LHC324/Valve-hall-charger/Document/Cubemx更新代码时手动变更部分.jpg

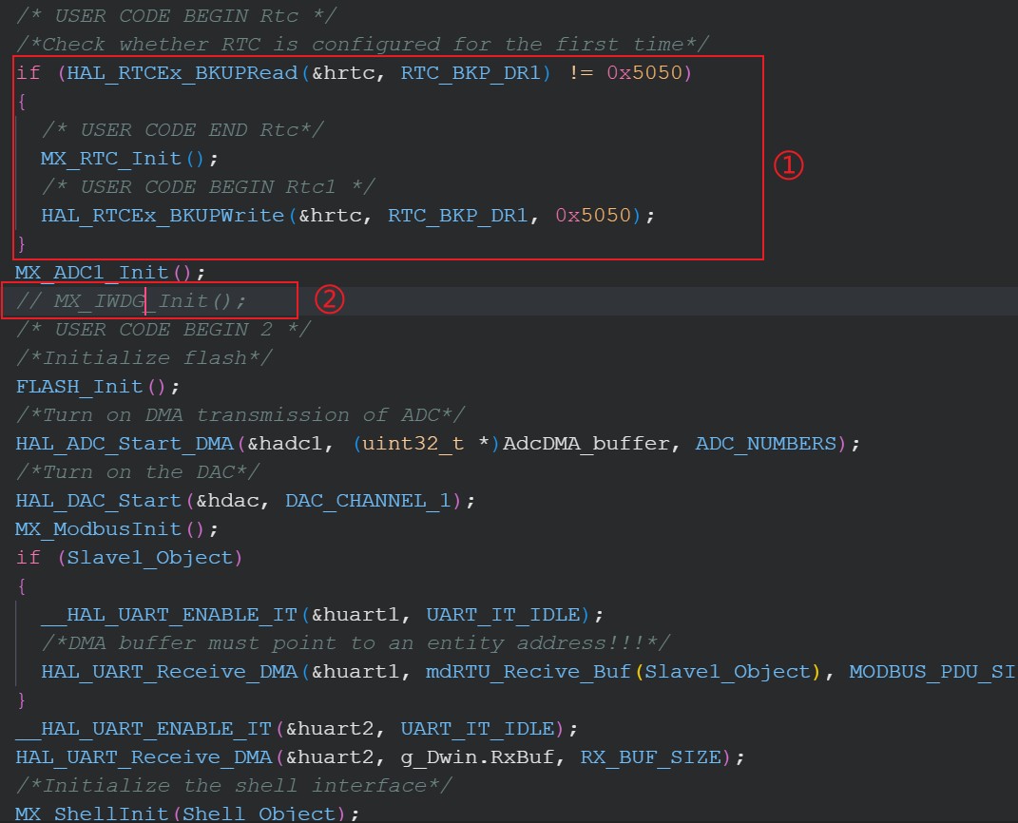
Document/Cubemx更新代码时手动变更部分.jpg
