LHC324/Valve-hall-charger/Dwin Project/DWIN_SET/02_充电设置.jpg

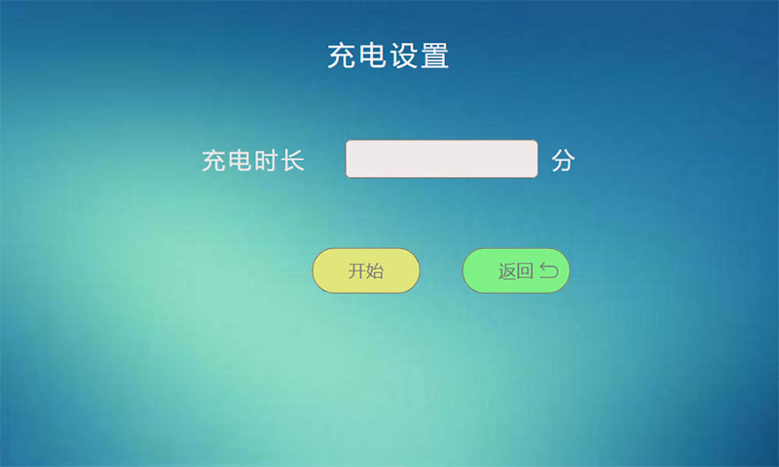
Dwin Project/DWIN_SET/02_充电设置.jpg
