LHC324/Valve-hall-charger/Dwin Project/DWIN_SET/03_放电设置.jpg

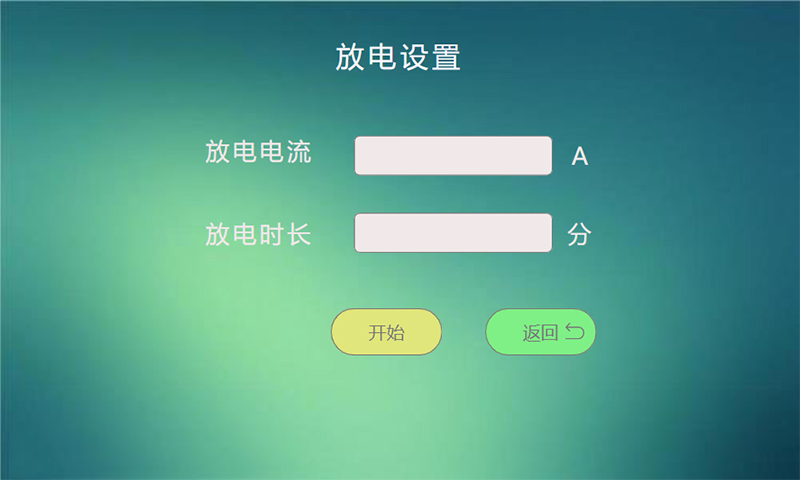
Dwin Project/DWIN_SET/03_放电设置.jpg
