LHC324/Valve-hall-charger/Dwin Project/DWIN_SET/04_高级参数设置选项.jpg

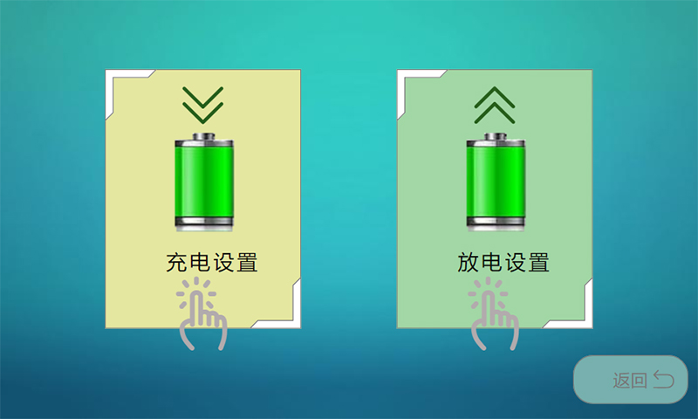
Dwin Project/DWIN_SET/04_高级参数设置选项.jpg
