LHC324/Valve-hall-charger/Dwin Project/DWIN_SET/05_高级充电设置1.jpg

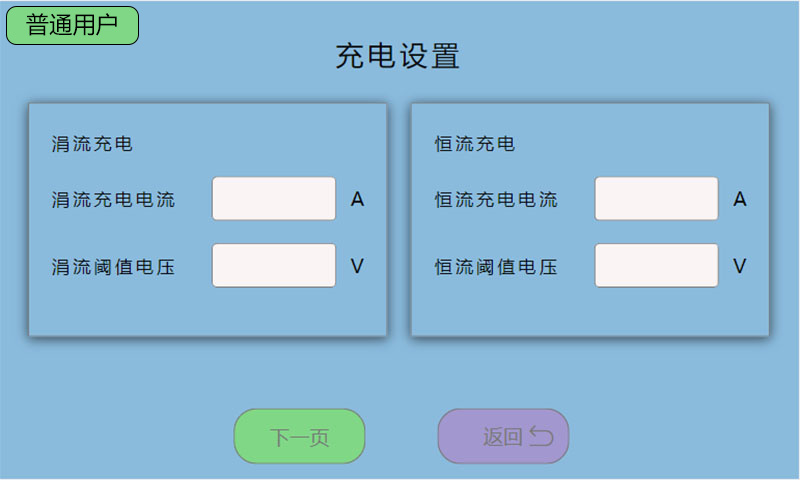
Dwin Project/DWIN_SET/05_高级充电设置1.jpg
