LHC324/Valve-hall-charger/Dwin Project/DWIN_SET/07_高级放电设置.jpg

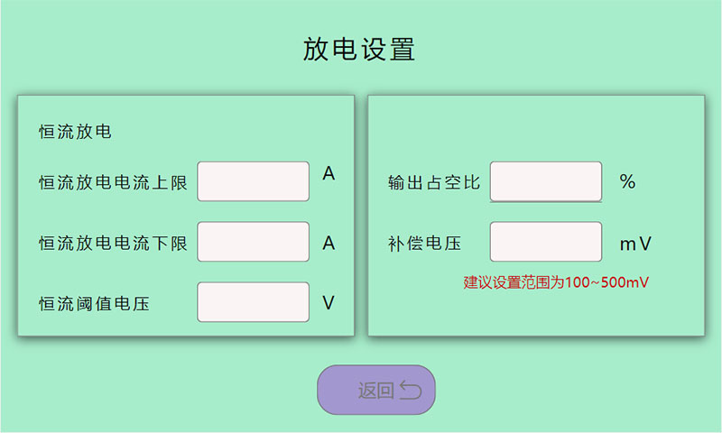
Dwin Project/DWIN_SET/07_高级放电设置.jpg
