LHC324/Valve-hall-charger/Dwin Project/DWIN_SET/08_时间设置.jpg

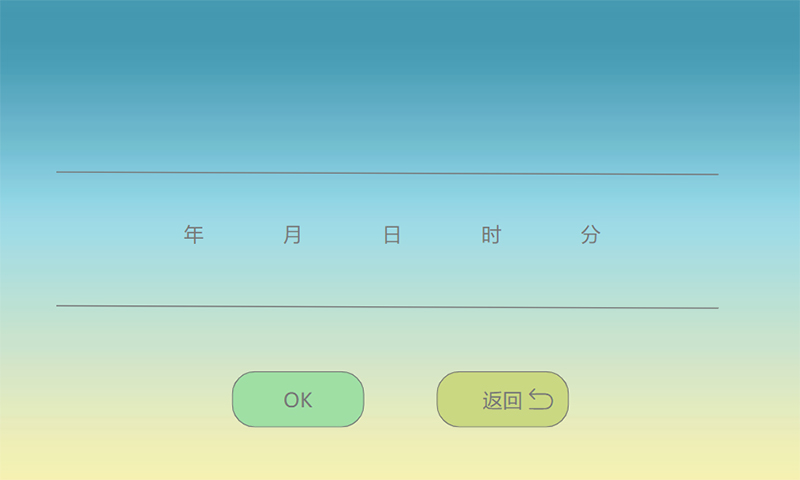
Dwin Project/DWIN_SET/08_时间设置.jpg
