LHC324/Valve-hall-charger/Dwin Project/DWIN_SET/09_密码.jpg

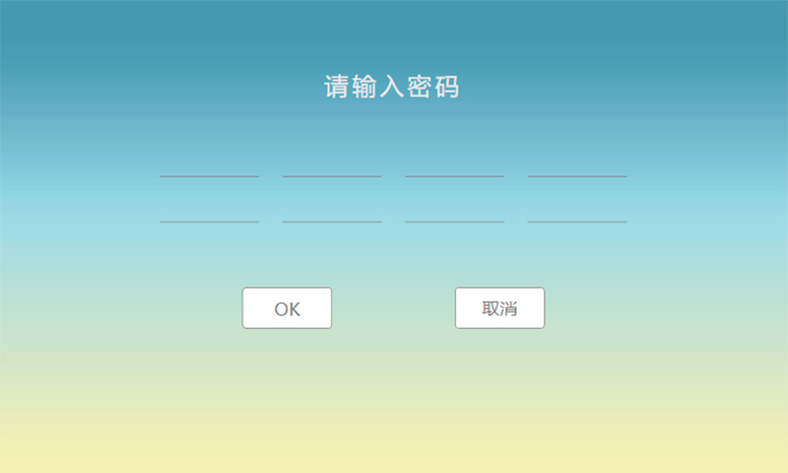
Dwin Project/DWIN_SET/09_密码.jpg
