LHC324/Valve-hall-charger/Dwin Project/DWIN_SET/11_放电显示界面.jpg

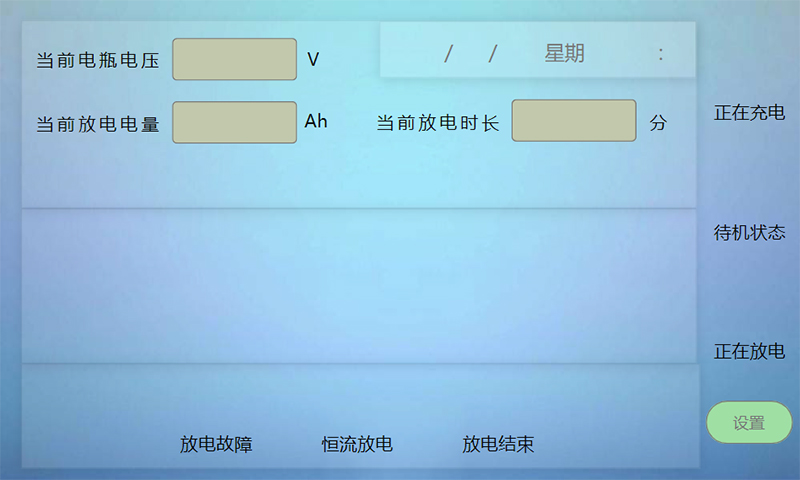
Dwin Project/DWIN_SET/11_放电显示界面.jpg
