LHC324/Valve-hall-charger/Dwin Project/DWIN_SET/16_高级充电设置2.jpg

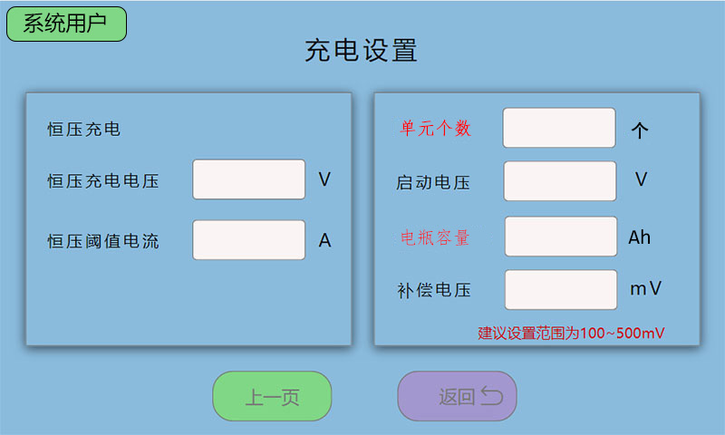
Dwin Project/DWIN_SET/16_高级充电设置2.jpg
