LHC324/Valve-hall-charger/Document/阀厅升降车蓄电池自动充放电控制器V1.0.1.pdf

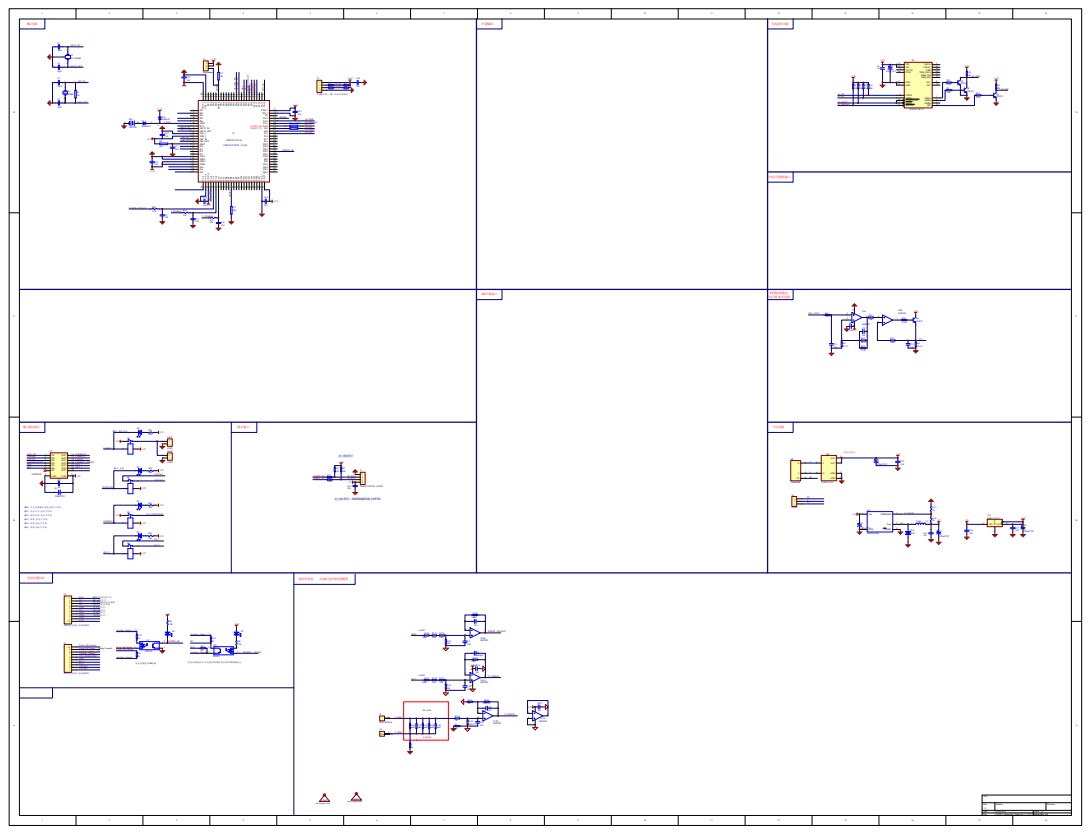
[picture p12: page 1]

RCG 对地远 程开关
RC 远程开关
PV 连接输出电压调整 PS 参考电压终端
