LHC324/Valve-hall-charger/Core/Src/main.c

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
/* Includes ------------------------------------------------------------------*/
#include "main.h"
#include "cmsis_os.h"
#include "adc.h"
#include "dac.h"
#include "dma.h"
#include "iwdg.h"
#include "rtc.h"
#include "usart.h"
#include "gpio.h"

/* USER CODE BEGIN Includes */
#include "mdrtuslave.h"
#include "shell_port.h"
#include "Dwin.h"
#include "Flash.h"
/* USER CODE END Includes */


void SystemClock_Config(void);
void MX_FREERTOS_Init(void);
/**
 * @brief  The application entry point.
 * @retval int
 */
int main(void)
{
  /* MCU Configuration--------------------------------------------------------*/

  /* Reset of all peripherals, Initializes the Flash interface and the Systick. */
  HAL_Init();

  /* Configure the system clock */
  SystemClock_Config();

  /* Initialize all configured peripherals */
  MX_GPIO_Init();
  MX_DMA_Init();
  MX_DAC_Init();
  MX_USART1_UART_Init();
  MX_USART2_UART_Init();
  MX_RTC_Init();
  MX_ADC1_Init();
  // MX_IWDG_Init();
  /* USER CODE BEGIN 2 */
  /*Initialize flash*/
  FLASH_Init();
  /*Turn on DMA transmission of ADC*/
  HAL_ADC_Start_DMA(&hadc1, (uint32_t *)AdcDMA_buffer, ADC_NUMBERS);
  /*Turn on the DAC*/
  HAL_DAC_Start(&hdac, DAC_CHANNEL_1);
  MX_ModbusInit();
  if (Slave1_Object)
  {
    __HAL_UART_ENABLE_IT(&huart1, UART_IT_IDLE);
    /*DMA buffer must point to an entity address!!!*/
    HAL_UART_Receive_DMA(&huart1, mdRTU_Recive_Buf(Slave1_Object), MODBUS_PDU_SIZE_MAX);
  }
  __HAL_UART_ENABLE_IT(&huart2, UART_IT_IDLE);
  HAL_UART_Receive_DMA(&huart2, g_Dwin.RxBuf, RX_BUF_SIZE);
  /*Initialize the shell interface*/
  MX_ShellInit(Shell_Object);
  /* USER CODE END 2 */

  /* Call init function for freertos objects (in freertos.c) */
  MX_FREERTOS_Init();

  /* Start scheduler */
  osKernelStart();

  /* We should never get here as control is now taken by the scheduler */
  /* Infinite loop */
  /* USER CODE BEGIN WHILE */
  while (1)
  {
    /* USER CODE END WHILE */

    /* USER CODE BEGIN 3 */
  }
  /* USER CODE END 3 */
}

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
/**
 * @brief  Period elapsed callback in non blocking mode
 * @note   This function is called  when TIM1 interrupt took place, inside
 * HAL_TIM_IRQHandler(). It makes a direct call to HAL_IncTick() to increment
 * a global variable "uwTick" used as application time base.
 * @param  htim : TIM handle
 * @retval None
 */
void HAL_TIM_PeriodElapsedCallback(TIM_HandleTypeDef *htim)
{
  if (htim->Instance == TIM1)
  {
    HAL_IncTick();
  }
}

/**
 * @brief  This function is executed in case of error occurrence.
 * @retval None
 */
void Error_Handler(void)
{
  /* USER CODE BEGIN Error_Handler_Debug */
  /* User can add his own implementation to report the HAL error return state */
  __disable_irq();
  while (1)
  {
  }
  /* USER CODE END Error_Handler_Debug */
}

#ifdef USE_FULL_ASSERT
/**
 * @brief  Reports the name of the source file and the source line number
 *         where the assert_param error has occurred.
 * @param  file: pointer to the source file name
 * @param  line: assert_param error line source number
 * @retval None
 */
void assert_failed(uint8_t *file, uint32_t line)
{
  /* USER CODE BEGIN 6 */
  /* User can add his own implementation to report the file name and line number,
     ex: printf("Wrong parameters value: file %s on line %d\r\n", file, line) */
  /* USER CODE END 6 */
}
#endif /* USE_FULL_ASSERT */
