LHC324/Valve-hall-charger/Valve hall charger.ioc

Mcu.UserName=STM32F103VCTx
PA10.Signal=USART1_RX
PA11.GPIO_Label=LTE_RELOAD
PA11.Signal=GPIO_Output
PA12.GPIO_Label=LTE_LINK
PA12.Signal=GPIO_Input
PA13.Signal=SYS_JTMS-SWDIO
PA14.Signal=SYS_JTCK-SWCLK
PA4.Signal=COMP_DAC1_group
PA6.Signal=ADCx_IN6
PA7.Signal=ADCx_IN7
PA8.GPIO_Label=LTE_RESET
PA8.Signal=GPIO_Output
PA9.Signal=USART1_TX
PB4.GPIO_Label=DISCHARGING_SWITCH
PB4.Signal=GPIO_Output
PC11.GPIO_Label=POWER_ON
PC11.Signal=GPIO_Output
PC12.GPIO_Label=CHARGING_GO
PC12.Signal=GPIO_Output
PC14-OSC32_IN.Signal=RCC_OSC32_IN
PC15-OSC32_OUT.Signal=RCC_OSC32_OUT
PC9.GPIO_Label=LTE_NET
PC9.Signal=GPIO_Input
PD0.GPIO_Label=FANS_POWER
PD0.Signal=GPIO_Output
PD1.GPIO_Label=CHARGING_READY
PD1.Signal=GPIO_Output
PD12.GPIO_Label=POWER_OK
PD12.Signal=GPIO_Input
PD2.GPIO_Label=Q04
PD2.Signal=GPIO_Output
PD3.GPIO_Label=Q0.5
PD3.Signal=GPIO_Output
PD5.Signal=USART2_TX
PD6.Signal=USART2_RX
