LHC324/Valve-hall-charger/Core/Inc/main.h

#define DEBUGGING 0
#define CUSTOM_MALLOC pvPortMalloc
#define CUSTOM_FREE vPortFree
#define CURRENT_SOFT_VERSION 100
#define UPDATE_FLAG_FLASH_PAGE 125U
#define UPDATE_SAVE_ADDRESS (FLASH_BASE + UPDATE_FLAG_FLASH_PAGE * FLASH_PAGE_SIZE)
#define CHARGE_SAVE_ADDRESS (STM32FLASH_BASE + 126U * FLASH_PAGE_SIZE) //充电数据存盘地址(126�?)
#define CLIBRATION_SAVE_ADDR (STM32FLASH_BASE + 127U * FLASH_PAGE_SIZE)
#define UPDATE_CMD 0x1234
#define UPDATE_APP1 0x5AA5
#define UPDATE_APP2 0xA55A
#define ESC_CODE 0x1B
#define BACKSPACE_CODE 0x08
#define ENTER_CODE 0x0D
#define SPOT_CODE 0x2E
#define COMMA_CODE 0x2C
#define POWER_OK_Pin GPIO_PIN_12
#define POWER_OK_GPIO_Port GPIOD
#define LTE_NET_Pin GPIO_PIN_9
#define LTE_NET_GPIO_Port GPIOC
#define LTE_RESET_Pin GPIO_PIN_8
#define LTE_RESET_GPIO_Port GPIOA
#define LTE_RELOAD_Pin GPIO_PIN_11
#define LTE_RELOAD_GPIO_Port GPIOA
#define LTE_LINK_Pin GPIO_PIN_12
#define LTE_LINK_GPIO_Port GPIOA
#define POWER_ON_Pin GPIO_PIN_11
#define POWER_ON_GPIO_Port GPIOC
#define CHARGING_GO_Pin GPIO_PIN_12
#define CHARGING_GO_GPIO_Port GPIOC
#define FANS_POWER_Pin GPIO_PIN_0
#define FANS_POWER_GPIO_Port GPIOD
#define CHARGING_READY_Pin GPIO_PIN_1
#define CHARGING_READY_GPIO_Port GPIOD
#define Q04_Pin GPIO_PIN_2
#define Q04_GPIO_Port GPIOD
#define Q0_5_Pin GPIO_PIN_3
#define Q0_5_GPIO_Port GPIOD
#define DISCHARGING_SWITCH_Pin GPIO_PIN_4
#define DISCHARGING_SWITCH_GPIO_Port GPIOB
