LHC324/Valve-hall-charger/Core/Inc/rtc.h

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
/* Define to prevent recursive inclusion -------------------------------------*/
#ifndef __RTC_H__
#define __RTC_H__

#ifdef __cplusplus
extern "C"
{
#endif

/* Includes ------------------------------------------------------------------*/
#include "main.h"

  extern RTC_HandleTypeDef hrtc;

  /* USER CODE BEGIN Private defines */
  extern RTC_DateTypeDef sdatestructure;
  extern RTC_TimeTypeDef stimestructure;
  /* USER CODE END Private defines */

  void MX_RTC_Init(void);

  /* USER CODE BEGIN Prototypes */
  uint32_t time2Stamp(RTC_DateTypeDef date, RTC_TimeTypeDef time);
  void Stamp2time(RTC_DateTypeDef *pdate, RTC_TimeTypeDef *ptime, uint32_t Stamp, int timezone);
  void myRtc_Get_DateTime(RTC_DateTypeDef *pdate, RTC_TimeTypeDef *ptime);
  void SetRtcCount(uint32_t tramp);
  /* USER CODE END Prototypes */

#ifdef __cplusplus
}
#endif

#endif /* __RTC_H__ */
