LHC324/Valve-hall-charger/(commit log)

2022-07-03 新版本首次提交
    [Backup of 电池组充电控制器V11.sch, DGUSII变量分配表.xls, DisplayConfig.xls, T5LCFG_DMG80480C043_01WTC.CFG, TouchConfig.xls, 远程升级Flash划分.xlsx, 阀厅充电器ADC与DAC校准.xlsx, 阀厅充电器测试项目.xls]
2022-08-30 修复了充电器诸多遗留问题
2022-08-30 修复了二次上电后，手动模式相关电压参数丢失问题
    [TouchConfig.xls]
